rblaze/erust-weather-station/hardware/scd_sensor/scd_sensor.kicad_pcb

## KiCad design hardware/scd_sensor/scd_sensor.kicad_pcb (2025-12-30)

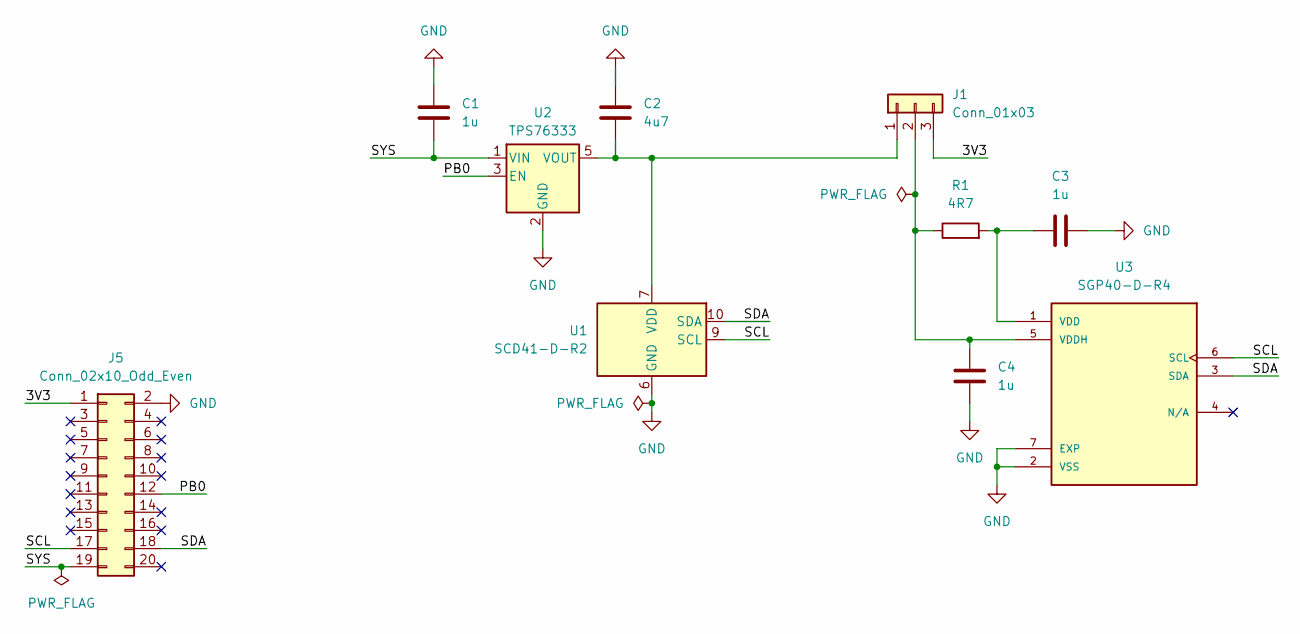
[picture p1: schematic scd_sensor.kicad_sch]

Parts:
C1, C3, C4: 1u; C_0402_1005Metric; JLCPCB C52923
C2: 4u7; C_0402_1005Metric; JLCPCB C23733
J1: Conn_01x03; PinHeader_1x03_P2.54mm_Vertical
J5: Conn_02x10_Odd_Even; PinHeader_2x10_P2.54mm_Vertical
R1: 4R7; R_0402_1005Metric; JLCPCB C23164
U1: SCD41-D-R2; Sensirion_SCD4x-1EP_10.1x10.1mm_P1.25mm_EP4.8x4.8mm; JLCPCB C3037696
U2: TPS76333; SOT-23-5
U3: SGP40-D-R4; XCDR_SGP40-D-R4; PARTREV 1.2; JLCPCB C2874215

Connections:
/3V3: J1.3, J5.1
/PB0: J5.12, U2.3 (EN)
/SCL: J5.17, U1.9 (SCL), U3.6 (SCL)
/SDA: J5.18, U1.10 (SDA), U3.3 (SDA)
/SYS: C1.2, J5.19, U2.1 (VIN)
GND: C1.1, C2.1, C3.2, C4.2, J5.2, U1.6 (GND), U1.20 (GND), U1.21 (GND), U2.2 (GND), U3.2 (VSS), U3.7 (EXP)
unnamed: C2.2, J1.1, U1.7 (VDD), U1.19 (VDD), U2.5 (VOUT)
unnamed: C4.1, J1.2, R1.1, U3.5 (VDDH)
unnamed: C3.1, R1.2, U3.1 (VDD)

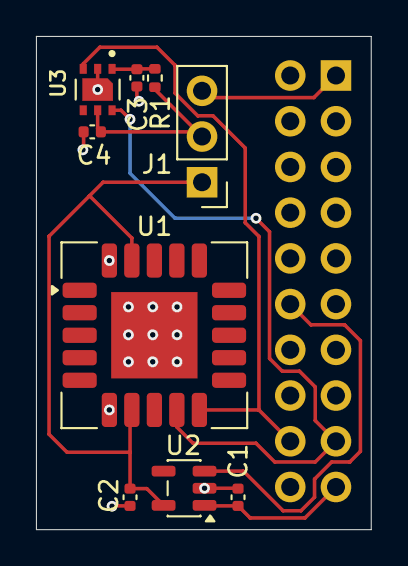
[picture p2: board scd_sensor.kicad_pcb from above]

Board: 2 copper layers, 18.6 x 27.4 mm, 10 parts (1 on the bottom side), 9 nets.
