rblaze/erust-weather-station/hardware/main_board/main_board.kicad_pcb

## KiCad design hardware/main_board/main_board.kicad_pcb (2025-10-17)

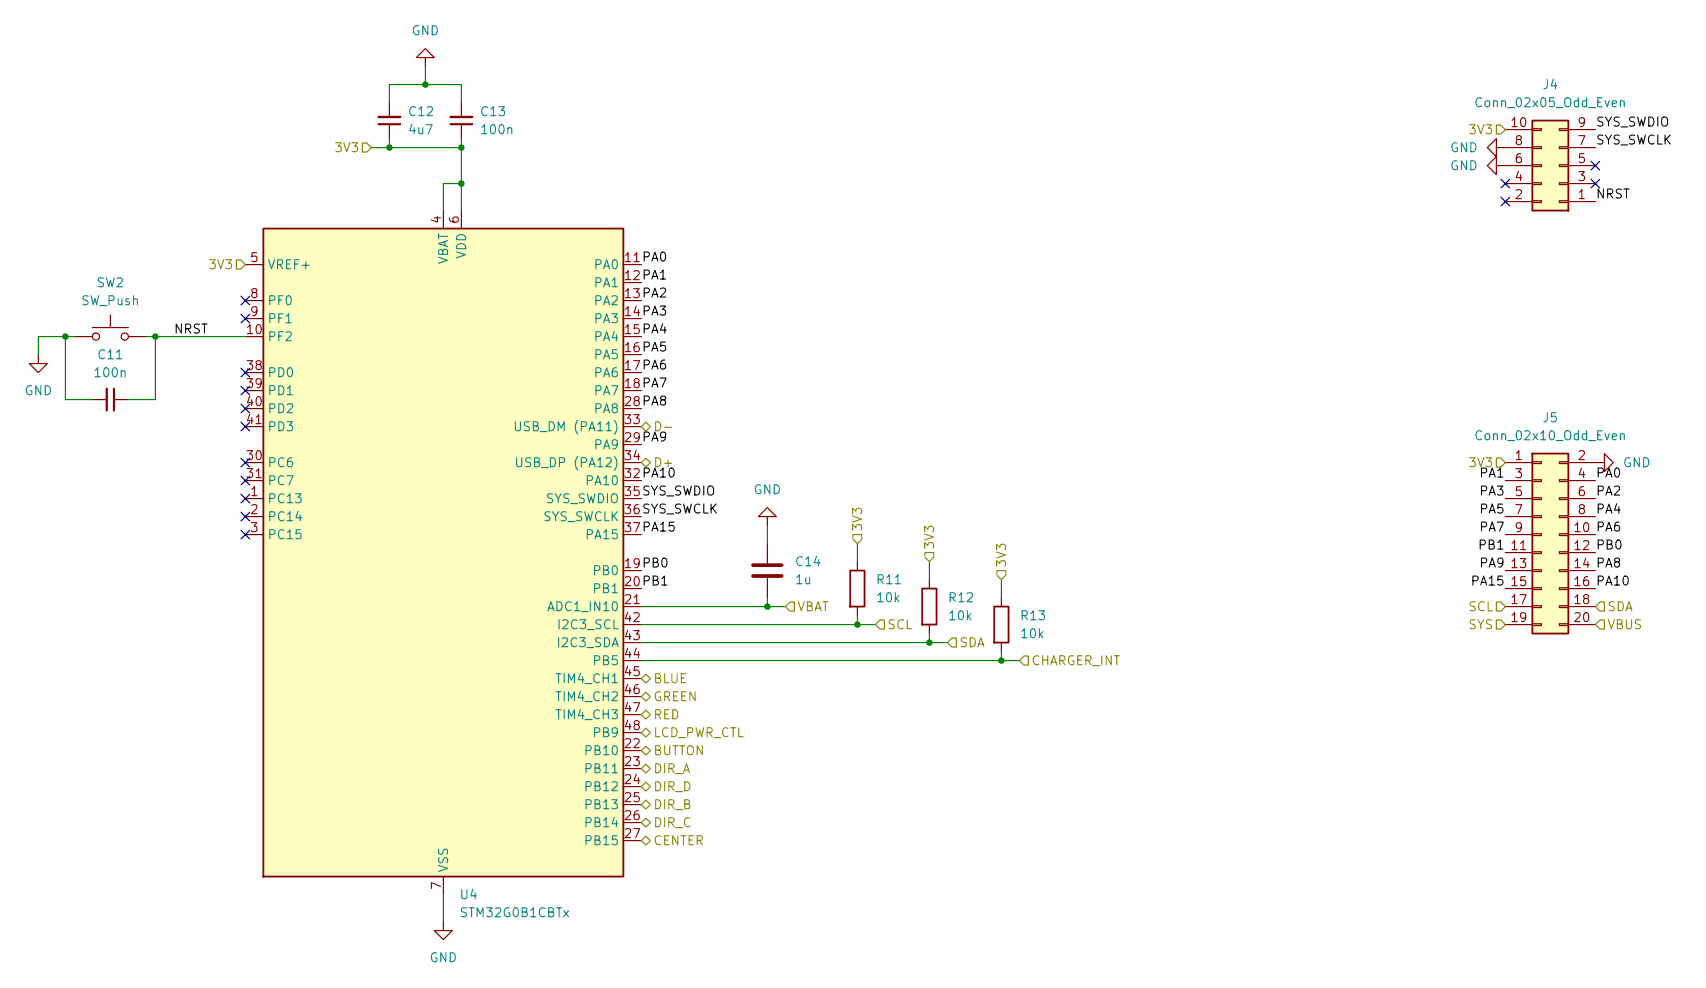
[picture p3: schematic mcu.kicad_sch]

Parts:
C11, C13: 100n; C_0402_1005Metric; JLCPCB C1525
C12: 4u7; C_0402_1005Metric; JLCPCB C23733
C14: 1u; C_0402_1005Metric; JLCPCB C52923
J4: Conn_02x05_Odd_Even; SAMTEC_FTSH-105-01-L-D-RA-K
J5: Conn_02x10_Odd_Even; SAMTEC_SSM-110-F-DH
R11, R12, R13: 10k; R_0402_1005Metric; JLCPCB C25744
SW2: SW_Push; SW_SPST_PTS810
U4: STM32G0B1CBTx; LQFP-48_7x7mm_P0.5mm; JLCPCB C2847904

Connections:
/MCU/3V3: C12.1, C13.1, J4.10, J5.1, R11.1, R12.1, R13.1, U4.4 (VBAT), U4.5 (VREF+), U4.6 (VDD); also elsewhere on the board
/MCU/BLUE: U4.45 (TIM4_CH1); also elsewhere on the board
/MCU/BUTTON: U4.22 (PB10); also elsewhere on the board
/MCU/CENTER: U4.27 (PB15); also elsewhere on the board
/MCU/CHARGER_INT: R13.2, U4.44 (PB5); also elsewhere on the board
/MCU/D+: U4.34 (USB_DP (PA12)); also elsewhere on the board
/MCU/D-: U4.33 (USB_DM (PA11)); also elsewhere on the board
/MCU/DIR_A: U4.23 (PB11); also elsewhere on the board
/MCU/DIR_B: U4.25 (PB13); also elsewhere on the board
/MCU/DIR_C: U4.26 (PB14); also elsewhere on the board
/MCU/DIR_D: U4.24 (PB12); also elsewhere on the board
/MCU/GREEN: U4.46 (TIM4_CH2); also elsewhere on the board
/MCU/LCD_PWR_CTL: U4.48 (PB9); also elsewhere on the board
/MCU/NRST: C11.1, J4.1, SW2.2, U4.10 (PF2)
/MCU/PA0: J5.4, U4.11 (PA0)
/MCU/PA1: J5.3, U4.12 (PA1)
/MCU/PA2: J5.6, U4.13 (PA2)
/MCU/PA3: J5.5, U4.14 (PA3)
/MCU/PA4: J5.8, U4.15 (PA4)
/MCU/PA5: J5.7, U4.16 (PA5)
/MCU/PA6: J5.10, U4.17 (PA6)
/MCU/PA7: J5.9, U4.18 (PA7)
/MCU/PA8: J5.14, U4.28 (PA8)
/MCU/PA9: J5.13, U4.29 (PA9)
/MCU/PA10: J5.16, U4.32 (PA10)
/MCU/PA15: J5.15, U4.37 (PA15)
/MCU/PB0: J5.12, U4.19 (PB0)
/MCU/PB1: J5.11, U4.20 (PB1)
/MCU/RED: U4.47 (TIM4_CH3); also elsewhere on the board
/MCU/SCL: J5.17, R11.2, U4.42 (I2C3_SCL); also elsewhere on the board
/MCU/SDA: J5.18, R12.2, U4.43 (I2C3_SDA); also elsewhere on the board
/MCU/SYS_SWCLK: J4.7, U4.36 (SYS_SWCLK)
/MCU/SYS_SWDIO: J4.9, U4.35 (SYS_SWDIO)
/MCU/VBAT: C14.2, U4.21 (ADC1_IN10); also elsewhere on the board
/MCU/VBUS: J5.20; also elsewhere on the board
/Power/SYS: J5.19; also elsewhere on the board
GND: C11.2, C12.2, C13.2, C14.1, J4.6, J4.8, J5.2, SW2.1, U4.7 (VSS); also elsewhere on the board

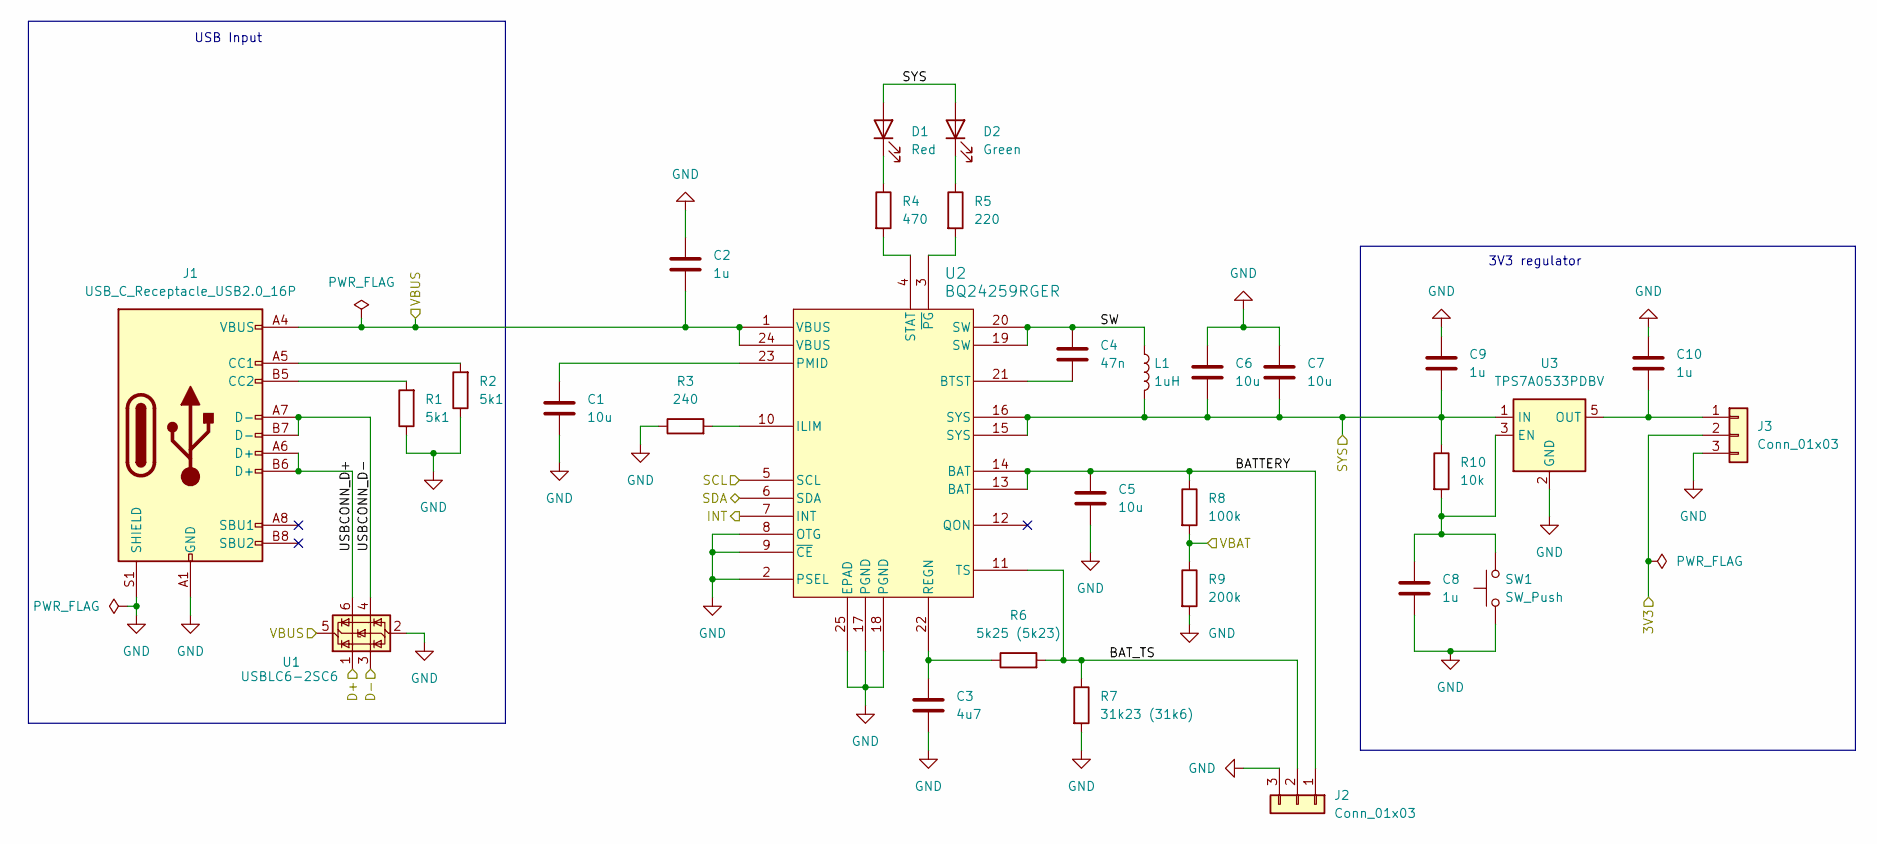
[picture p4: schematic power.kicad_sch, Power subsystem]

Parts:
C1, C5, C6, C7: 10u; C_0603_1608Metric; JLCPCB C19702
C2, C8, C9, C10: 1u; C_0402_1005Metric; JLCPCB C52923
C3: 4u7; C_0402_1005Metric; JLCPCB C23733
C4: 47n; C_0402_1005Metric; JLCPCB C384812
D1: Red; LED_0805_2012Metric; JLCPCB C2286
D2: Green; LED_0805_2012Metric; JLCPCB C72043
J1: USB_C_Receptacle_USB2.0_16P; USB_C_Receptacle_GCT_USB4105-xx-A_16P_TopMnt_Horizontal; JLCPCB C165948
J2: Conn_01x03; JST_PH_S3B-PH-SM4-TB_1x03-1MP_P2.00mm_Horizontal
J3: Conn_01x03; Harwin_M20-89003xx_1x03_P2.54mm_Horizontal
L1: 1uH; L_Murata_DFE201610P; JLCPCB C161082
R1, R2: 5k1; R_0402_1005Metric; JLCPCB C25905
R3: 240; R_0402_1005Metric; JLCPCB C25091
R4: 470; R_0402_1005Metric; JLCPCB C25117
R5: 220; R_0402_1005Metric; JLCPCB C25091
R6: 5k25 (5k23); R_0402_1005Metric; JLCPCB C852857
R7: 31k23 (31k6); R_0402_1005Metric; JLCPCB C852720
R8: 100k; R_0402_1005Metric; JLCPCB C25741
R9: 200k; R_0402_1005Metric; JLCPCB C25764
R10: 10k; R_0402_1005Metric; JLCPCB C25744
SW1: SW_Push; SW_SPST_PTS810
U1: USBLC6-2SC6; SOT-23-6; JLCPCB C7519
U2: BQ24259RGER; RGE24_2P7X2P7_TEX; JLCPCB C473366
U3: TPS7A0533PDBV; SOT-23-5; JLCPCB C2862740

Connections:
/MCU/3V3: J3.2; also elsewhere on the board
/MCU/CHARGER_INT: U2.7 (INT); also elsewhere on the board
/MCU/D+: U1.1 (I/O1); also elsewhere on the board
/MCU/D-: U1.3 (I/O2); also elsewhere on the board
/MCU/SCL: U2.5 (SCL); also elsewhere on the board
/MCU/SDA: U2.6 (SDA); also elsewhere on the board
/MCU/VBAT: R8.2, R9.1; also elsewhere on the board
/MCU/VBUS: C2.2, J1.A4 (VBUS), J1.A9 (VBUS), J1.B4 (VBUS), J1.B9 (VBUS), U1.5 (VBUS), U2.1 (VBUS), U2.24 (VBUS); also elsewhere on the board
/Power/BATTERY: C5.1, J2.1, R8.1, U2.13 (BAT), U2.14 (BAT)
/Power/BAT_TS: J2.2, R6.2, R7.1, U2.11 (TS)
/Power/SW: C4.1, L1.1, U2.19 (SW), U2.20 (SW)
/Power/SYS: C6.2, C7.2, C9.2, D1.2 (A), D2.2 (A), L1.2, R10.1, U2.15 (SYS), U2.16 (SYS), U3.1 (IN); also elsewhere on the board
/Power/USBCONN_D+: J1.A6 (D+), J1.B6 (D+), U1.6 (I/O1)
/Power/USBCONN_D-: J1.A7 (D-), J1.B7 (D-), U1.4 (I/O2)
GND: C1.2, C2.1, C3.2, C5.2, C6.1, C7.1, C8.2, C9.1, C10.1, J1.A1 (GND), J1.A12 (GND), J1.B1 (GND), J1.B12 (GND), J1.S1 (SHIELD), J2.3, J3.3, R1.1, R2.1, R3.1, R7.2, R9.2, SW1.1, U1.2 (GND), U2.2 (PSEL), U2.8 (OTG), U2.9 (~CE), U2.17 (PGND), U2.18 (PGND), U2.25 (EPAD), U2.V, U3.2 (GND); also elsewhere on the board
unnamed: D1.1 (K), R4.1
unnamed: D2.1 (K), R5.1
unnamed: J1.A5 (CC1), R2.2
unnamed: J1.B5 (CC2), R1.2
unnamed: C10.2, J3.1, U3.5 (OUT)
unnamed: C4.2, U2.21 (BTST)
unnamed: R3.2, U2.10 (ILIM)
unnamed: C1.1, U2.23 (PMID)
unnamed: C3.1, R6.1, U2.22 (REGN)
unnamed: R4.2, U2.4 (STAT)
unnamed: R5.2, U2.3 (~PG)
unnamed: C8.1, R10.2, SW1.2, U3.3 (EN)

Notes on the sheet:
3V3 regulator
USB Input

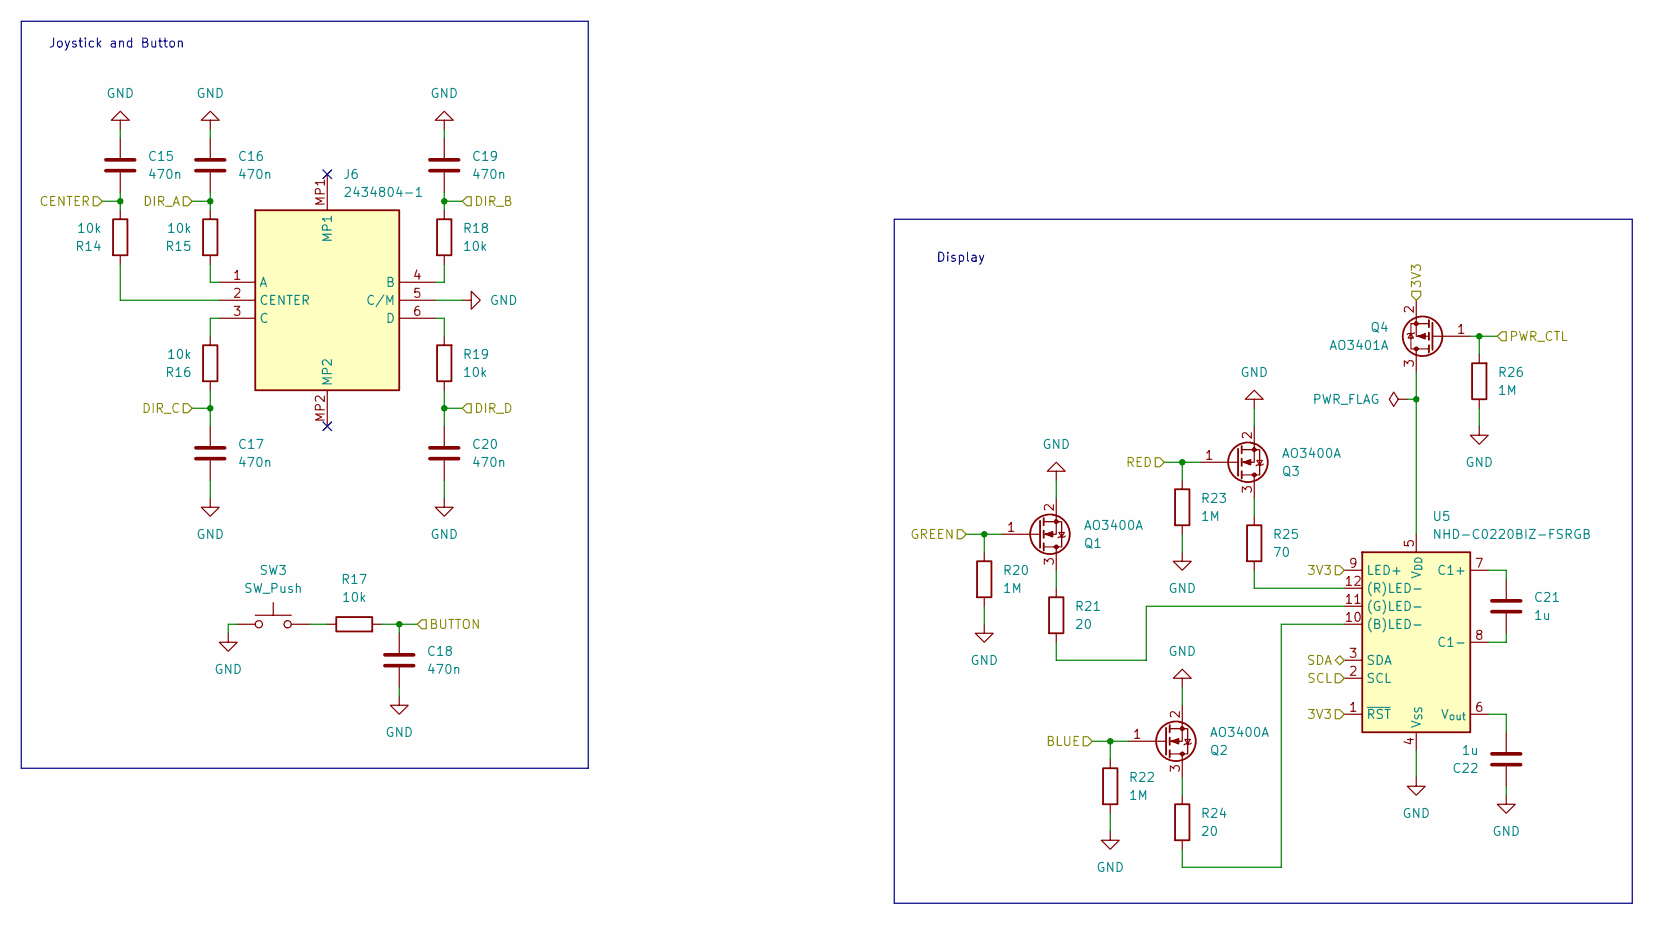
[picture p5: schematic controls_lcd.kicad_sch]

Parts:
C15, C16, C17, C18, C19, C20: 470n; C_0402_1005Metric; JLCPCB C47339
C21, C22: 1u; C_0402_1005Metric; JLCPCB C52923
J6: 2434804-1; TE_24348041; Manufacturer_Part_Number 2434804-1
Q1, Q2, Q3: AO3400A; SOT-23; JLCPCB C22469448
Q4: AO3401A; SOT-23; JLCPCB C28646269
R14, R15, R16, R17, R18, R19: 10k; R_0402_1005Metric; JLCPCB C25744
R20, R22, R23, R26: 1M; R_0402_1005Metric; JLCPCB C26083
R21, R24: 20; R_0402_1005Metric; JLCPCB C25092
R25: 70; R_0402_1005Metric; JLCPCB C25133
SW3: SW_Push; SW_SPST_PTS810
U5: NHD-C0220BIZ-FSRGB; NHD-C0220BiZ-FSRGB_no_mount

Connections:
/MCU/3V3: Q4.2 (S), U5.1 (~RST), U5.9 (LED+); also elsewhere on the board
/MCU/BLUE: Q2.1 (G), R22.1; also elsewhere on the board
/MCU/BUTTON: C18.1, R17.2; also elsewhere on the board
/MCU/CENTER: C15.1, R14.1; also elsewhere on the board
/MCU/DIR_A: C16.1, R15.1; also elsewhere on the board
/MCU/DIR_B: C19.1, R18.1; also elsewhere on the board
/MCU/DIR_C: C17.2, R16.2; also elsewhere on the board
/MCU/DIR_D: C20.2, R19.1; also elsewhere on the board
/MCU/GREEN: Q1.1 (G), R20.1; also elsewhere on the board
/MCU/LCD_PWR_CTL: Q4.1 (G), R26.2; also elsewhere on the board
/MCU/RED: Q3.1 (G), R23.1; also elsewhere on the board
/MCU/SCL: U5.2 (SCL); also elsewhere on the board
/MCU/SDA: U5.3 (SDA); also elsewhere on the board
GND: C15.2, C16.2, C17.1, C18.2, C19.2, C20.1, C22.1, J6.5 (C/M), Q1.2 (S), Q2.2 (S), Q3.2 (S), R20.2, R22.2, R23.2, R26.1, SW3.2, U5.4 (V_{SS}); also elsewhere on the board
unnamed: J6.1 (A), R15.2
unnamed: J6.4 (B), R18.2
unnamed: J6.3 (C), R16.1
unnamed: J6.2 (CENTER), R14.2
unnamed: J6.6 (D), R19.2
unnamed: Q1.3 (D), R21.1
unnamed: Q2.3 (D), R24.1
unnamed: Q3.3 (D), R25.1
unnamed: Q4.3 (D), U5.5 (V_{DD})
unnamed: R17.1, SW3.1
unnamed: R24.2, U5.10 ((B)LED-)
unnamed: R21.2, U5.11 ((G)LED-)
unnamed: R25.2, U5.12 ((R)LED-)
unnamed: C21.1, U5.7 (C1+)
unnamed: C21.2, U5.8 (C1-)
unnamed: C22.2, U5.6 (V_{out})

Notes on the sheet:
Display
Joystick and Button

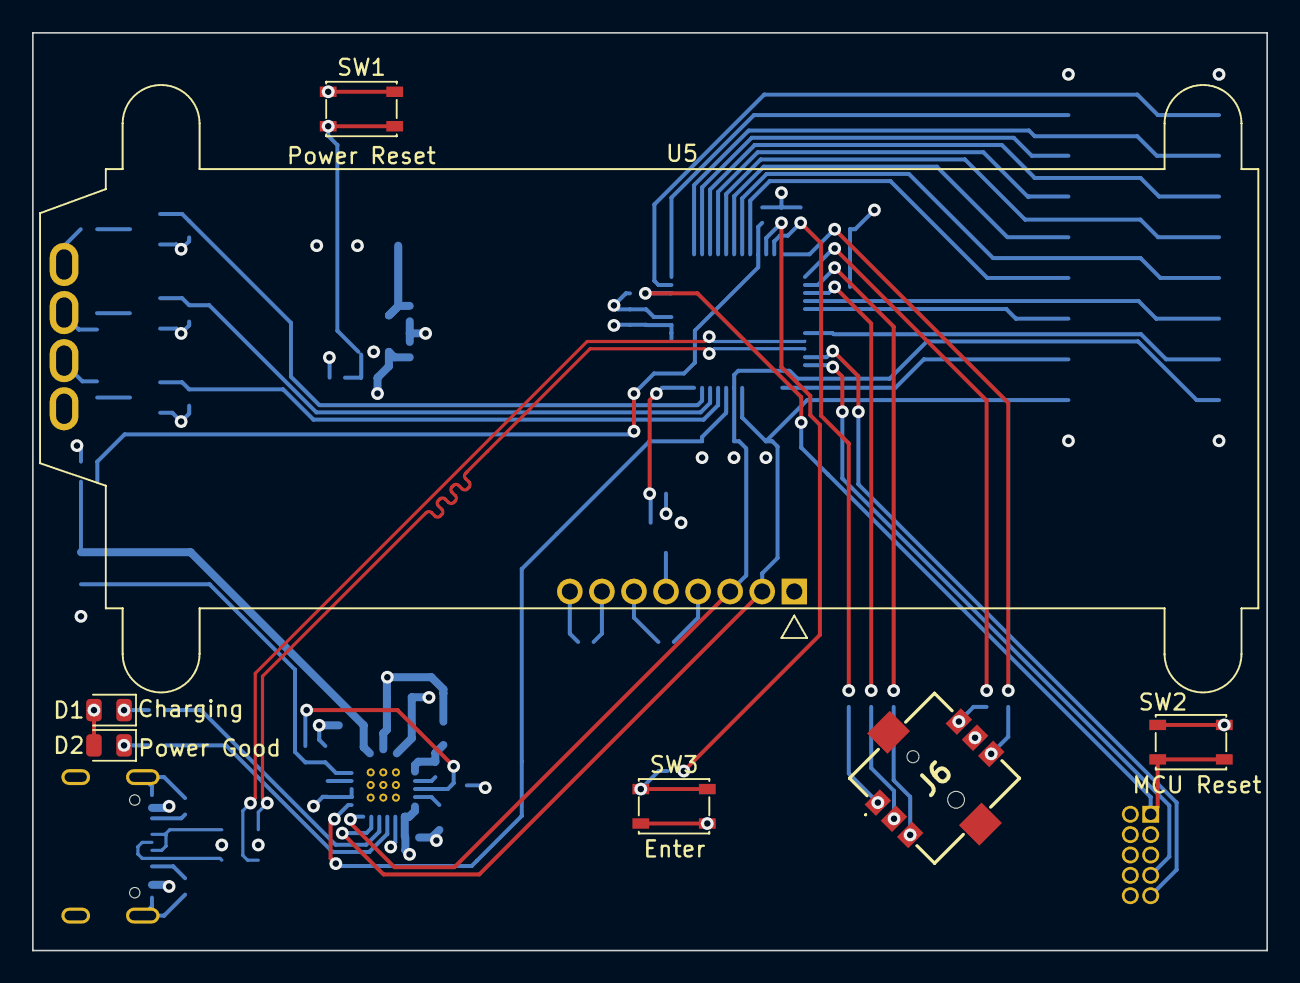
[picture p6: board main_board.kicad_pcb from above]

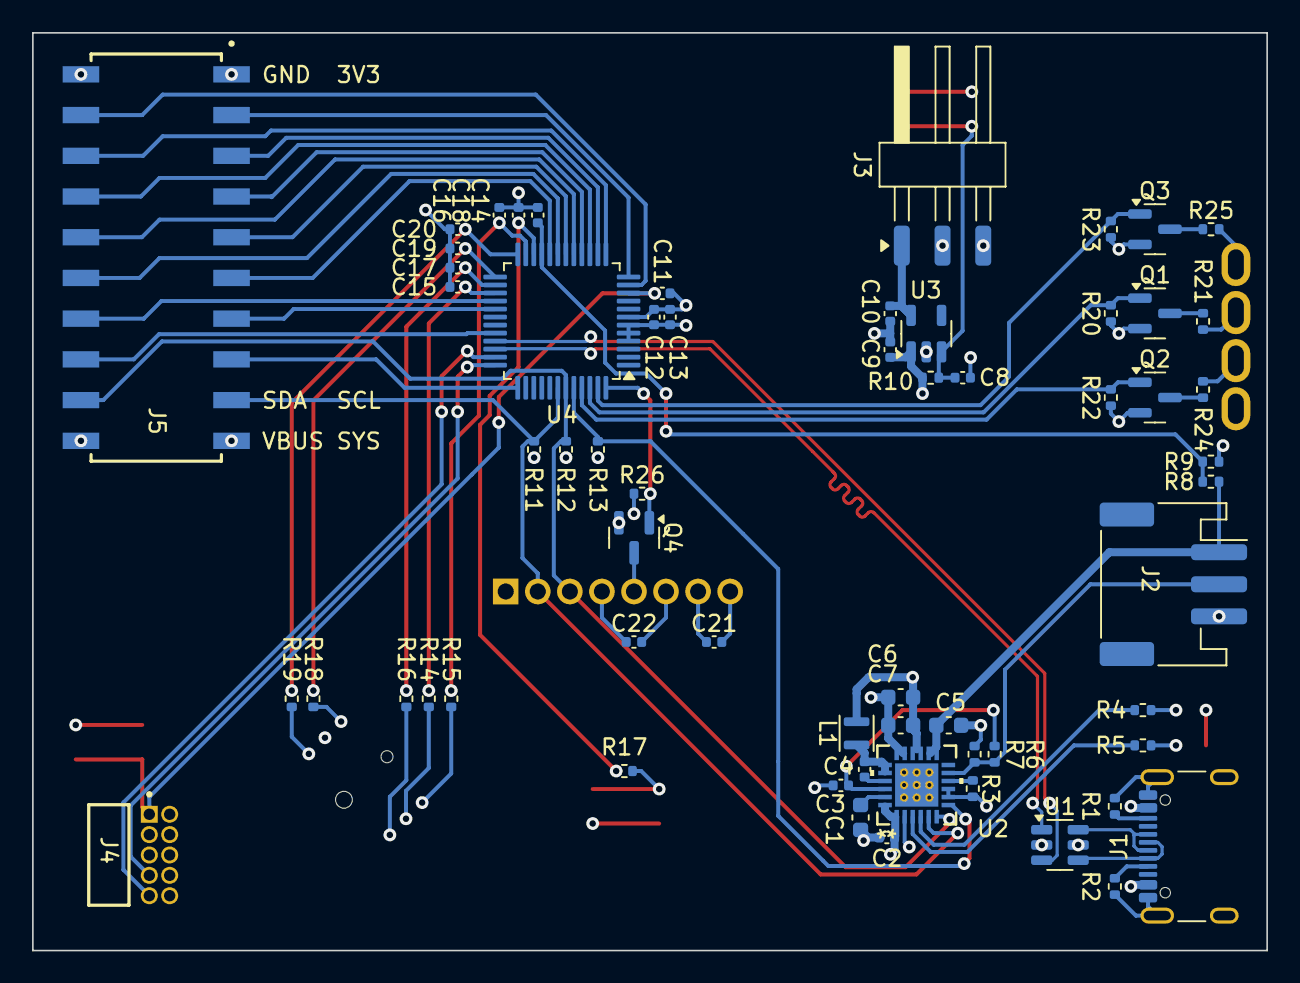
[picture p7: board main_board.kicad_pcb from below]

Board: 4 copper layers, 77.0 x 57.2 mm, 69 parts (62 on the bottom side), 70 nets.
