rblaze/erust-weather-station/firmware/src/types.rs

use core::cell::RefCell;
use core::marker::PhantomData;

use embedded_hal::i2c::I2c;
use embedded_hal::pwm::SetDutyCycle;

pub trait EventWaiter {
    #[allow(async_fn_in_trait)]
    async fn wait(&self);
}

pub trait OnOff {
    fn on(&mut self);
    fn off(&mut self);
}

pub trait Watchdog {
    fn feed(&self);
}

pub trait Joystick {
    fn up(&mut self) -> bool;
    fn down(&mut self) -> bool;
    fn left(&mut self) -> bool;
    fn right(&mut self) -> bool;
    fn select(&mut self) -> bool;
    fn button(&mut self) -> bool;
}

pub trait VoltageReader {
    fn millivolts(&mut self) -> u16;
}

pub trait UsbSerial<Error> {
    /// Synchronously writes to port as much as possible and does not block.
    fn write(&self, buf: &[u8]) -> Result<usize, Error>;
}

pub struct Backlight<R: SetDutyCycle, G: SetDutyCycle, B: SetDutyCycle> {
    pub red: R,
    pub green: G,
    pub blue: B,
}

pub struct Board<
    E,
    J: Joystick + EventWaiter,
    V: VoltageReader,
    D: OnOff,
    U: UsbSerial<E>,
    P: OnOff,
    C: EventWaiter,
    W: Watchdog,
    I2cBus: I2c,
    R: SetDutyCycle,
    G: SetDutyCycle,
    B: SetDutyCycle,
> {
    pub joystick: J,
    pub vbat: V,
    pub backlight: Backlight<R, G, B>,
    pub display_power: D,
    pub usb_serial: U,
    pub usb_power: P,
    pub charger_event: C,
    pub i2c: RefCell<I2cBus>,
    pub watchdog: W,
    pub _phantom: PhantomData<E>,
}
