rblaze/erust-weather-station/firmware/src/screen.rs

use embedded_hal::i2c::I2c;
use lcd::hd44780::*;
use lcd::screen::Screen;
use lcd::st7036::*;

use crate::error::{Error, I2cError};
use crate::time::{Duration, sleep};

enum TransactionMode {
    Command = 0b0000_0000,
    Data = 0b0100_0000,
}

const I2C_ADDR: u8 = 0x3C;
const WIDTH: usize = 20;
const HEIGHT: usize = 2;

pub struct Lcd<I2cBus> {
    i2c: I2cBus,
}

impl<I2cBus: I2c> Lcd<I2cBus> {
    pub fn new(i2c: I2cBus) -> Self {
        Self { i2c }
    }

    pub async fn reset(&mut self) -> Result<(), Error<I2cBus::Error>> {
        self.send_commands(INIT_SEQUENCE[0])?;
        sleep(Duration::from_ticks(1)).await;
        self.send_commands(INIT_SEQUENCE[1])?;
        sleep(Duration::from_ticks(1)).await;
        self.send_commands(INIT_SEQUENCE[2])?;
        Ok(())
    }

    pub fn set_output_line(&mut self, line: usize) -> Result<(), Error<I2cBus::Error>> {
        if line > 1 {
            return Err(Error::InvalidLcdLine);
        }
        self.send_command(set_ddram_address(line as u8 * 0x40))?;
        Ok(())
    }
}

impl<I2cBus: I2c> Screen<WIDTH, HEIGHT, I2cError<I2cBus::Error>> for Lcd<I2cBus> {
    fn send_command(&mut self, command: u8) -> Result<(), I2cError<I2cBus::Error>> {
        self.i2c
            .write(I2C_ADDR, &[TransactionMode::Command as u8, command])?;
        Ok(())
    }

    fn send_data(&mut self, data: u8) -> Result<(), I2cError<I2cBus::Error>> {
        self.i2c
            .write(I2C_ADDR, &[TransactionMode::Data as u8, data])?;
        Ok(())
    }

    fn send_data_bytes(&mut self, data: &[u8]) -> Result<(), I2cError<I2cBus::Error>> {
        if data.len() > 1 && data.len() <= WIDTH {
            // Fast path. Copying a few bytes in the memory is faster
            // than repeating I2C transactions.
            let mut buf = [0; WIDTH + 1];
            buf[0] = TransactionMode::Data as u8;
            buf[1..data.len() + 1].copy_from_slice(data);
            self.i2c.write(I2C_ADDR, &buf[..data.len() + 1])?;
        } else {
            // Slow path.
            for byte in data {
                self.send_data(*byte)?;
            }
        }
        Ok(())
    }
}

impl<I2cBus: I2c> core::fmt::Write for Lcd<I2cBus> {
    fn write_str(&mut self, s: &str) -> core::fmt::Result {
        self.write(s).map_err(|_| core::fmt::Error)
    }
}
