rblaze/erust-weather-station/(commit log)

2023-10-12 Do reliable reads of current tick count.
2023-10-13 Add basic LCD driver
2023-10-13 Refactor LCD driver
2023-10-15 Move LCD driver to a crate
2023-10-16 Prevent hanging at startup in release mode
    [system_time.rs]
2023-10-17 Use stop mode in release builds while waiting for interrupt
2023-10-17 Use I2C in normal mode
2023-10-23 Add kicad project for main board
    rblaze/issue_tracker#5
    [main_board.kicad_pcb, main_board.kicad_sch, mcu_lcd_controls.kicad_sch, power.kicad_sch]
2023-10-23 Update pin types
2023-10-23 WIP: power module
    [power.kicad_sch]
2024-03-18 Update I2C to embedded_hal 1.0
2024-03-18 Make LCD independent from I2C bus implementation
2024-03-18 Fix bug in data copy
    [screen.rs]
2024-03-18 Bump rtt-target from 0.4.0 to 0.5.0
    Bumps [rtt-target](https://github.com/probe-rs/rtt-target) from 0.4.0 to 0.5.0.
    - [Release notes](https://github.com/probe-rs/rtt-target/releases)
    - [Commits](https://github.com/probe-rs/rtt-target/compare/v0.4.0...v0.5.0)
    ---
    updated-dependencies:
    - dependency-name: rtt-target
    dependency-type: direct:production
    update-type: version-update:semver-minor
    ...
2024-03-21 Switch to 64-bit time
2024-04-03 Use STM32G071 MCU
    Squashed commit of the following:
    commit ea5f54d0a32e90bbd2bc651b61d5a11e5d5142a2
    Author: Andrey Sverdlichenko <blaze@rusty.zone>
    Date: Tue Apr 2 23:57:28 2024 -0400
    Add pushbutton
    commit 1ac1216a19ab01139f5a65c0bd3a0802a8212238
    Author: Andrey Sverdlichenko <blaze@rusty.zone>
    Date: Tue Apr 2 23:57:11 2024 -0400
    Fix timer setup
    commit 4d4f13fc53a3dbe801b5a9744bd9cbeb023267f9
    Author: Andrey Sverdlichenko <blaze@rusty.zone>
    Date: Tue Apr 2 13:15:04 2024 -0400
    Update to recent async-scheduler
    commit 503ff03a7047e90e236dedb93b17300c51b42176
    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
    [board.rs, env.rs, hal_i2c.rs, main.rs, system_time.rs]
2024-04-04 Add navigation buttons
2024-04-04 Add battery voltage reading
2024-04-04 Add charger control
2024-04-06 Separate display refresh from charger watchdog
2024-04-11 Fix LPTIM reload process.
    LPTIM is finicky and gets stuck if CMP value is reloaded too fast,
    CMPOK isn't cleared immediatelly or for other reasons. This version
    of code works, though it behaves weirdly too if HSI is not divided.
    [board.rs, env.rs, error.rs, main.rs, system_time.rs]
2024-04-22 Switch to LQFP chip
2024-04-22 Add display power control
2024-04-22 Fix lptim2 CMP reads
    [system_time.rs]
2024-04-24 Power cycle display on error
    [main.rs]
2024-04-24 Add power data
2024-10-08 Fix LPTIM HAL and use
    [system_time.rs]
2024-10-08 Generalize ResetEnable implementation and add basic timers
2024-10-08 Refactor timer API
2024-10-08 Switch joystick pins to microhal
2024-10-08 Implement PWM in microhal
2024-10-08 Generate PWM via macros
2024-10-08 Add ADC to microhal
2024-10-08 Simplify Board struct
2024-10-08 Update voltage divider ratio for vbat
2024-10-27 Add I2C support
2024-10-27 Generalize I2C
2024-10-27 Add comments to I2C code
2024-10-31 Add interrupt control to GPIO
2024-11-02 Use nightly build of stm32g0
2024-11-03 Switch board to STM32G0B1
2024-11-20 Update to latest stm32g0 through hal
2024-12-02 Bump rtt-target from 0.5.0 to 0.6.0 (#16)
    Bumps [rtt-target](https://github.com/probe-rs/rtt-target) from 0.5.0 to 0.6.0.
    - [Commits](https://github.com/probe-rs/rtt-target/compare/v0.5.0...rtt-target-v0.6.0)
    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
2024-12-09 Bump rtt-target from 0.6.0 to 0.6.1 (#18)
    Bumps [rtt-target](https://github.com/probe-rs/rtt-target) from 0.6.0 to 0.6.1.
    - [Commits](https://github.com/probe-rs/rtt-target/compare/rtt-target-v0.6.0...rtt-target-v0.6.1)
    update-type: version-update:semver-patch
    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
2024-12-09 Bump stm32g0-hal from `390c4a3` to `f3c2507` (#17)
    Bumps [stm32g0-hal](https://github.com/rblaze/erust-stm32g0-hal) from `390c4a3` to `f3c2507`.
    - [Commits](https://github.com/rblaze/erust-stm32g0-hal/compare/390c4a337540c00da703a5b46e6397d88e46de72...f3c25070894787dfeb88ab539130e2afc6acb042)
    - dependency-name: stm32g0-hal
    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
2024-12-31 Use interrupts to handle USB comms
2024-12-31 Power down USB when charger reports no external power
2025-01-15 Add flow control to USB serial port
2025-01-19 Power on-off USB
2025-01-20 Remove serial LED
2025-01-20 Use charger interrupt line for state updates
2025-02-03 Add debug LEDs blinking during interrupts
2025-02-05 Update mainboard schematic to match breadboard
    [controls_lcd.kicad_sch, main_board.kicad_sch, mcu.kicad_sch, mcu_lcd_controls.kicad_sch, power.kicad_sch]
2025-02-05 Add probe connector
    [mcu.kicad_sch, power.kicad_sch]
2025-02-06 Add daughter board connector
    [controls_lcd.kicad_sch, main_board.kicad_sch, mcu.kicad_sch, power.kicad_sch]
2025-02-12 Board schematic complete
    [controls_lcd.kicad_sch, mcu.kicad_sch, power.kicad_sch]
2025-02-13 Add right-angle TTH debug connector footprint
2025-06-02 Routed mainboard PCB
    [controls_lcd.kicad_sch, main_board.kicad_pcb, mcu.kicad_sch, power.kicad_sch]
2025-06-10 Update component IDs
    [controls_lcd.kicad_sch, main_board.kicad_pcb, mcu.kicad_sch, power.kicad_sch]
2025-06-16 Convert kicad project to v9.0
    [controls_lcd.kicad_sch, main_board.kicad_pcb, main_board.kicad_sch, mcu.kicad_sch, power.kicad_sch]
2025-07-02 Fix PCB routing errors, update LED and connector footprints
    [main_board.kicad_pcb, mcu.kicad_sch, power.kicad_sch]
2025-07-03 Minor PCB file changes
    [main_board.kicad_pcb]
2025-09-01 Correct orientation of the debug connector
    [mcu.kicad_sch]
2025-09-10 Route 4-layer PCB
    [controls_lcd.kicad_sch, main_board.kicad_pcb, mcu.kicad_sch, power.kicad_sch]
2025-09-22 Add CO2 sensor board
    [scd_sensor.kicad_pcb, scd_sensor.kicad_sch]
2025-10-08 Add SYS power to the extension socket
    [main_board.kicad_pcb, main_board.kicad_sch, mcu.kicad_sch, power.kicad_sch]
2025-10-17 Add expansion socket markings
    [main_board.kicad_pcb]
2025-10-20 Bump rtt-target from 0.6.1 to 0.6.2 (#24)
    Bumps [rtt-target](https://github.com/probe-rs/rtt-target) from 0.6.1 to 0.6.2.
    - [Commits](https://github.com/probe-rs/rtt-target/compare/rtt-target-v0.6.1...rtt-target-v0.6.2)
    dependency-version: 0.6.2
    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
2025-11-10 Add SGP40 symbol and footprint
2025-11-16 Add sensor board
    [scd_sensor.kicad_pcb, scd_sensor.kicad_sch]
2025-11-16 Change plot settings
    [scd_sensor.kicad_pcb]
2025-12-12 Use thiserror to derive Error
    [error.rs]
2025-12-30 Add periodic measurements from SCD4x sensor
2025-12-30 Fix SDA/SCL placement on SGP40
    [scd_sensor.kicad_pcb, scd_sensor.kicad_sch]
2025-12-30 Add pin names to the board
    [scd_sensor.kicad_pcb]
2025-12-30 Add kicad_libraries submodule
2025-12-30 Move custom footprints to kicad_libraries
2025-12-30 Remove unwanted footprints
2025-12-31 Move SGP40 symbol to kicad_symbols
2026-01-03 Move charger watchdog task to a module
2026-02-01 Update Kicad libraries
2026-03-01 Add VOC sensor support
2026-03-02 Refactor code to use trait-based board API.
    This will allow adding tests with simulated hardware.
2026-03-13 Enable IWDG to restart the firmware in case of transient errors
    [charger.rs, hardware.rs, main.rs, types.rs]
2026-03-29 Move charger module to firmware crate
2026-03-29 Refactor LPTIM interrupt handler
2026-03-29 Move buttons module to firmware crate
2026-04-05 Show battery charging status
2026-04-05 Increase charger watchdog timeout to 160 seconds.
    This allows to wake up device less often.
2026-04-05 Undo charger timeout change
    IWDG has 32 seconds timeout, so device have to wakeup at least that often anyway.
2026-04-06 Move board support modules to top level
    Now that firmware is in separate crate, there is no need for submodules.
